janolada/Piezoelectric-Charging-Station/piezo_station/firmware/data/assets/icpep.jpg

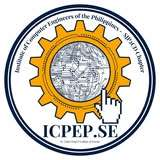
piezo_station/firmware/data/assets/icpep.jpg
