janolada/Piezoelectric-Charging-Station/piezo_station/firmware/data/assets/ike.jpg

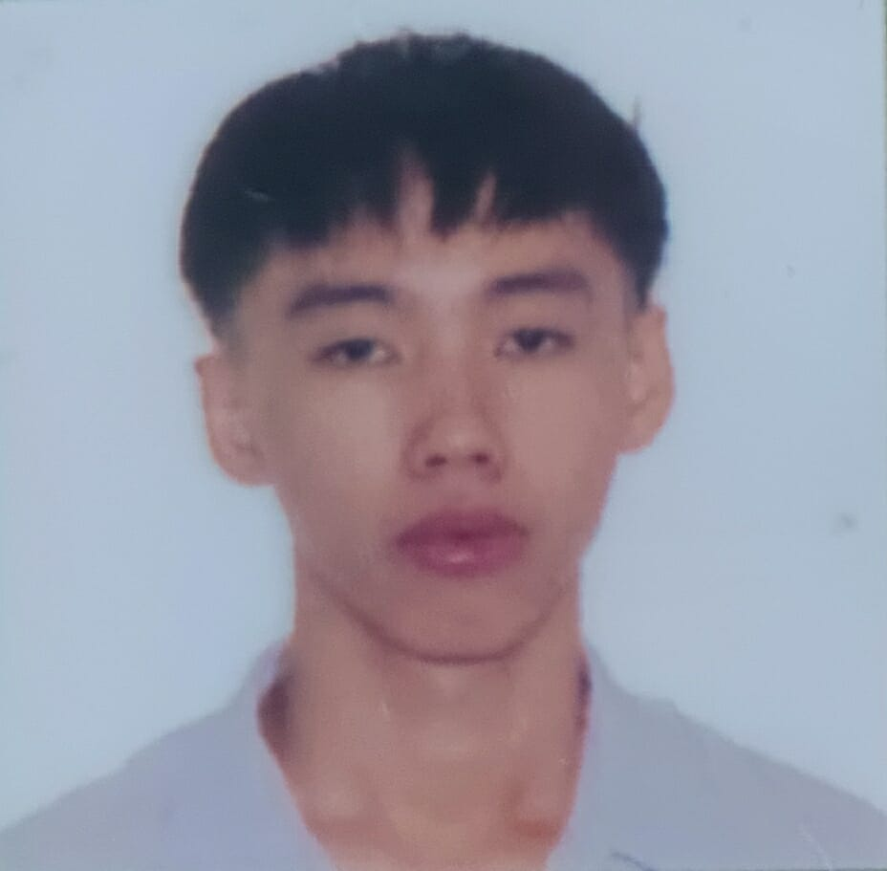
piezo_station/firmware/data/assets/ike.jpg
