janolada/Piezoelectric-Charging-Station/piezo_station/README.md

# PiezoStation: Smart Piezoelectric Energy Harvesting Charging Station

**PiezoStation** is an IoT-enabled charging station that harvests energy from piezoelectric transducers and provides secure, code-protected charging slots for mobile devices. This capstone project combines renewable energy harvesting, embedded systems control, and a web-based user interface for a complete smart charging solution.

## Project Objectives

* **Renewable Energy Harvesting:** Captures electrical energy generated by applying mechanical stress to PZT ceramic discs, storing it via a custom power management circuit.
* **Secure Access Control:** Manages three independent charging slots using a non-blocking servo state machine and randomized 4-digit unlock codes.
* **Real-Time Monitoring:** Calculates and displays bus voltage, current, and total harvested energy using an INA219 sensor in a low-side configuration.
* **Offline IoT Dashboard:** Hosts a responsive web application directly on the ESP32 using SPIFFS (SPI Flash File System), requiring no external internet connection.

## System Architecture & Technology Stack

* **Microcontroller:** ESP32-WROOM-32 (Dual-core, 240MHz) operating in WiFi Access Point Mode.
* **Firmware:** C++ / Arduino Framework featuring custom REST API handlers and non-blocking task management to prevent system delays during servo actuation.
* **Frontend Interface:** HTML5, CSS3, ES6 JavaScript, and Chart.js 4.4.1 for asynchronous data visualization.
* **Hardware Components:** INA219 Current/Voltage Sensor (I2C), SG90 Micro Servos (PWM), TP4056 Li-ion Charger, and a 3.7V 18650 Battery.

## Getting Started

### Prerequisites
* Arduino IDE with the ESP32 Board Manager installed.
* ESP32 Sketch Data Upload Plugin (required for SPIFFS).

### Installation & Setup
1. Clone this repository to your local environment.
2. Open `PiezoStation.ino` in the Arduino IDE.
3. Ensure the following library dependencies are installed: `ESP32Servo`, `Adafruit_INA219`, and `WiFi`.
4. Use the "ESP32 Sketch Data Upload" tool to upload the contents of the `/data` folder to the ESP32 SPIFFS.
5. Compile and upload the firmware to the ESP32 development board.
6. Power the system. The ESP32 will generate a WiFi Access Point with the SSID `PiezoStation`.
7. Connect to the network and navigate to `192.168.4.1` in a standard web browser to access the control dashboard.

## Repository Structure

* `/firmware`: Contains the core ESP32 C++ code (`PiezoStation.ino`) and library dependencies.
* `/firmware/data`: Contains the SPIFFS web server files (`index.html`, `style.css`, `dashboard.js`, `chart.min.js`).
* `/hardware`: Contains circuit designs, schematics, and the Bill of Materials.
* `/docs`: Contains comprehensive technical documentation and API endpoint references.

## Authors

Developed by students of St. John Paul II College of Davao (Bachelor of Science in Computer Engineering, Academic Year 2025-2026):

* **Johncel Anthony Lada** - Software & Systems Developer
* **Riche Kye Pobadora** - Hardware & Circuit Designer
* **Ike Hingo** - Researcher & Documentation 
---
*� 2026 PiezoStation Development Team. All rights reserved.*
