janolada/Piezoelectric-Charging-Station/piezo_station/docs/Technical Documentation.md

# PiezoStation: Smart Piezoelectric Energy Harvesting Charging Station

## Complete Technical Summary

---

## EXECUTIVE SUMMARY

**Project Title**: PiezoStation - Piezoelectric Energy Harvesting Charging Station  
**Institution**: St. John Paul II College of Davao, College of Engineering  
**Program**: Bachelor of Science in Computer Engineering  
**Academic Year**: 2025-2026  
**Project Type**: Capstone/Thesis Project

**Team Members**:

- **Ike Hingo** - Researcher & Documentation Specialist
- **Johncel Anthony Lada** - Software Engineer & Systems Developer
- **Riche Kye Pobadora** - Hardware Engineer & Circuit Designer

**Project Description**: PiezoStation is an innovative IoT-enabled charging station that harvests energy from piezoelectric transducers and provides secure, code-protected charging slots for mobile devices. The system combines renewable energy harvesting, embedded systems control, and web-based user interface for a complete smart charging solution.

---

## TABLE OF CONTENTS

Project Objectives

System Architecture

Hardware Components

Software Implementation

Energy Harvesting Technology

System Operation & Workflows

Technical Specifications

Circuit Design & Schematics

Code Documentation

Testing & Validation

Challenges & Solutions

Results & Performance

Future Enhancements

Conclusion
---

## 1. PROJECT OBJECTIVES

### Primary Objectives

1. **Harvest renewable energy** from piezoelectric elements
2. **Store harvested energy** efficiently in rechargeable battery
3. **Provide secure device charging** with access control
4. **Monitor battery energy state** in real-time via INA219 sensor
5. **Enable remote control** via web interface

### Secondary Objectives

1. Demonstrate practical IoT implementation
2. Integrate embedded systems with web technologies
3. Create user-friendly interface for non-technical users
4. Implement security measures for device protection
5. Provide data analytics for energy monitoring

### Learning Outcomes

- **Embedded Systems**: ESP32 programming, sensor integration
- **Web Development**: Full-stack dashboard creation
- **Hardware Design**: Circuit assembly, mechanical integration
- **Energy Systems**: Understanding piezoelectric technology
- **Project Management**: Team collaboration, documentation

---

## 2. SYSTEM ARCHITECTURE

### 2.1 High-Level Architecture

```
┌─────────────────────────────────────────────────────────────┐
│                    USER INTERFACE LAYER                      │
│  ┌──────────────┐  ┌──────────────┐  ┌──────────────┐      │
│  │   Web App    │  │  Mobile View │  │ Admin Panel  │      │
│  │ (Dashboard)  │  │ (Responsive) │  │  (Control)   │      │
│  └──────┬───────┘  └──────┬───────┘  └──────┬───────┘      │
└─────────┼──────────────────┼──────────────────┼─────────────┘
          │                  │                  │
          └──────────────────┴──────────────────┘
                             │ HTTP/JSON
                             │ WiFi (192.168.4.1)
          ┌──────────────────┴──────────────────┐
          │                                     │
┌─────────┴─────────────────────────────────────┴─────────────┐
│               APPLICATION LAYER (ESP32)                      │
│  ┌──────────────┐  ┌──────────────┐  ┌──────────────┐      │
│  │  Web Server  │  │  REST API    │  │ State Machine│      │
│  │   (Port 80)  │  │  (Handlers)  │  │   (Servos)   │      │
│  └──────┬───────┘  └──────┬───────┘  └──────┬───────┘      │
│         │                  │                  │              │
│  ┌──────┴──────────────────┴──────────────────┴───────┐     │
│  │          Business Logic & Control                   │     │
│  │  • Slot Management  • Code Generation               │     │
│  │  • Energy Calculation • Security Validation         │     │
│  └──────────────────────────┬──────────────────────────┘     │
└─────────────────────────────┼────────────────────────────────┘
                              │
          ┌───────────────────┴───────────────────┐
          │                                       │
┌─────────┴──────────────┐           ┌───────────┴────────────┐
│   HARDWARE LAYER       │           │   SENSOR LAYER         │
│  ┌──────────────────┐  │           │  ┌──────────────────┐  │
│  │  Servo 1 (GPIO14)│  │           │  │  INA219 (I2C)    │  │
│  │  Servo 2 (GPIO27)│  │           │  │  • Bus Voltage   │  │
│  │  Servo 3 (GPIO26)│  │           │  │  • Shunt Voltage │  │
│  │  (0° - 90°)      │  │           │  │  • Current (mA)  │  │
│  └──────────────────┘  │           │  │  • Power (mW)    │  │
└────────────────────────┘           │  └──────────────────┘  │
                                     └────────────────────────┘
          │                                       │
          └───────────────────┬───────────────────┘
                              │
┌─────────────────────────────┴────────────────────────────────┐
│                    POWER LAYER                                │
│  ┌─────────────────────────────────────────────────────┐     │
│  │  Piezoelectric Elements → Bridge Rectifier →        │     │
│  │  → Voltage Regulator → 18650 Battery (3.0-4.2V)     │     │
│  └─────────────────────────────────────────────────────┘     │
└───────────────────────────────────────────────────────────────┘
```

### 2.2 Data Flow Diagram

```
User Action (Web) → WiFi → ESP32 → Validate → Execute → Update State
                                        ↓
                                   Servo/Sensor
                                        ↓
                                   Read Status
                                        ↓
                                   JSON Response
                                        ↓
                                   Update Dashboard
```

---

## 3. HARDWARE COMPONENTS

### 3.1 Main Components

#### ESP32 Development Board

- **Model**: ESP32-WROOM-32
- **Processor**: Dual-core Xtensa LX6 @ 240MHz
- **Memory**: 520KB SRAM, 4MB Flash
- **WiFi**: 802.11 b/g/n (2.4GHz)
- **GPIO**: 34 programmable pins
- **ADC**: 12-bit, 18 channels
- **I2C**: 2 interfaces
- **PWM**: 16 channels
- **Operating Voltage**: 3.3V
- **Input Voltage**: 5V (USB) or 7-12V (VIN)

**Functions in Project**:

- WiFi Access Point creation
- Web server hosting
- API request handling
- Servo motor control (PWM)
- I2C sensor communication
- Data processing and storage

#### Servo Motors (3× SG90)

- **Type**: Micro servo (180° rotation)
- **Operating Voltage**: 4.8V - 6V
- **Current**: ~100mA (idle), ~500mA (stall)
- **Torque**: 1.8 kg/cm @ 4.8V
- **Speed**: 0.12 sec/60° @ 4.8V
- **Control**: PWM (50Hz, 1-2ms pulse width)
- **Weight**: 9g
- **Dimensions**: 22.2×11.8×31mm

**Control Angles**:

- 0° (1ms pulse) = Door LOCKED
- 90° (1.5ms pulse) = Door UNLOCKED
- Detached after movement to save power

#### INA219 Current/Voltage Sensor

- **Interface**: I2C (address 0x40)
- **Voltage Range**: 0-26V (bus voltage)
- **Current Range**: ±3.2A (with 0.1Ω shunt)
- **Resolution**: 12-bit ADC
- **Accuracy**: ±0.5% (voltage), ±1% (current)
- **Update Rate**: ~1Hz in firmware
- **Operating Voltage**: 3-5.5V

**Measurements**:

- Bus voltage (V)
- Shunt voltage (mV)
- Current (mA)
- Power (mW)
- Calculated battery voltage

#### 18650 Li-ion Battery

- **Nominal Voltage**: 3.7V
- **Voltage Range**: 3.0V (cutoff) - 4.2V (max)
- **Typical Capacity**: 2000-3500mAh
- **Chemistry**: Lithium-ion (LiCoO2)
- **Charge Rate**: 0.5C - 1C
- **Discharge Rate**: 1C - 2C continuous
- **Cycle Life**: 300-500 cycles

**Protection Required**:

- Overcharge protection (>4.2V)
- Over-discharge protection (<3.0V)
- Short circuit protection
- Temperature monitoring

### 3.2 Piezoelectric Elements

#### Specifications

- **Type**: PZT ceramic discs or patches
- **Size**: 27mm or 35mm diameter
- **Voltage Output**: 10-30V AC (peak)
- **Current Output**: 0.1-1mA (depends on force)
- **Resonant Frequency**: ~4-6kHz
- **Force Required**: 10-50N (1-5kg)

#### Energy Generation

- **Principle**: Piezoelectric effect (mechanical → electrical)
- **Application**: Foot traffic, manual pressing, vibrations
- **Output Type**: AC voltage pulses
- **Typical Power**: 1-10mW per element (intermittent)

### 3.3 Supporting Components

#### Power Management

- **Bridge Rectifier**: AC to DC conversion (1N4007 diodes)
- **Voltage Regulator**: 5V output for ESP32 (LM7805 or buck converter)
- **Capacitors**: Smoothing (100µF, 1000µF electrolytic)
- **Battery Charger**: TP4056 Li-ion charging module

#### Mechanical Components

- **Enclosure**: 3D printed or acrylic case
- **Door Mechanism**: Servo-actuated latches
- **Mounting**: Servo brackets, battery holder
- **Piezo Platform**: Pressure distribution platform

---

## 4. SOFTWARE IMPLEMENTATION

### 4.1 Firmware Architecture (ESP32)

#### File Structure

```
PiezoStation/
├── PiezoStation.ino          # Main firmware
├── data/                      # SPIFFS web files
│   ├── index.html            # Dashboard UI
│   ├── style.css             # Styling
│   ├── dashboard.js          # Frontend logic
│   ├── chart.min.js          # Chart.js library
│   └── images/               # Team photos, logos
├── libraries/                 # Dependencies
│   ├── ESP32Servo/
│   ├── Adafruit_INA219/
│   └── WiFi/
└── README.md                  # Documentation
```

#### Main Components

**1. Configuration Section**

```cpp
// WiFi credentials
const char* ssid = "PiezoStation";
const char* password = "12345678";

// Admin security
const char* ADMIN_SECURITY_KEY = "PZSTAT001";

// Servo pins and angles
const int servoPins[3] = {14, 27, 26};
const int SERVO_LOCKED_ANGLE = 0;
const int SERVO_UNLOCKED_ANGLE = 90;
```

**2. Data Structures**

```cpp
// Slot state management
struct Slot {
  bool occupied;      // true if device stored
  String code;        // 4-digit unlock code
};
Slot slotData[3];     // Array for 3 slots

// Servo state machine
enum ServoState { IDLE, MOVING, COOLDOWN };
struct ServoTask {
  ServoState state;
  unsigned long startTime;
  int slotIndex;
  int targetAngle;
};
```

**3. Non-Blocking Servo Control**

```cpp
void updateServos() {
  // State: IDLE → MOVING → COOLDOWN → IDLE
  switch (currentTask.state) {
    case MOVING:
      if (elapsed >= SERVO_MOVE_DELAY) {
        currentTask.state = COOLDOWN;
      }
      break;
    case COOLDOWN:
      if (elapsed >= SERVO_DETACH_DELAY) {
        servo->detach();  // Save power
        currentTask.state = IDLE;
      }
      break;
  }
}
```

**4. Energy Calculation Algorithm**

```cpp
void readSensors() {
  // Read INA219
  float voltage = getBatteryVoltage();
  float current = getCurrent();
  
  // Calculate energy
  float elapsedSeconds = (now - lastRead) / 1000.0;
  float chargeCoulombs = current * elapsedSeconds;
  float energyJoules = chargeCoulombs * voltage;
  
  // Accumulate
  totalHarvestedEnergy += energyJoules;
}
```

**5. API Endpoints**

```cpp
server.on("/getData", HTTP_GET, handleGetData);
server.on("/requestLock", HTTP_GET, handleRequestLock);
server.on("/confirmLock", HTTP_GET, handleConfirmLock);
server.on("/unlockSlot", HTTP_GET, handleUnlockSlot);
server.on("/adminUnlock", HTTP_GET, handleAdminUnlock);
server.on("/adminReset", HTTP_GET, handleAdminReset);
```

### 4.2 Web Dashboard (Frontend)

#### Technology Stack

- **HTML5**: Semantic structure
- **CSS3**: Modern styling, flexbox, grid
- **JavaScript (ES6+)**: Async/await, fetch API
- **Chart.js 4.4.1**: Real-time data visualization
- **Responsive Design**: Mobile-first approach

#### Key Features

**1. Real-Time Updates**

```javascript
// Poll server every 2 seconds
setInterval(fetchData, 2000);

async function fetchData() {
  const response = await fetch('/getData');
  const data = await response.json();
  updateUI(data);
}
```

**2. Slot Management**

```javascript
async function handleSlotClick(slotId) {
  if (slotOccupied) {
    // Show unlock modal
    showUnlockModal(slotId);
  } else {
    // Request lock, get code
    const response = await fetch(`/requestLock?slot=${slotId}`);
    const {code} = await response.json();
    displayCode(code);
  }
}
```

**3. Energy Visualization**

```javascript
// Chart.js configuration
const chart = new Chart(ctx, {
  type: 'line',
  data: {
    datasets: [
      {label: 'Voltage (V)', data: voltageData},
      {label: 'Energy (J)', data: energyData}
    ]
  }
});
```

**4. Admin Panel**

```javascript
// Secured with password
if (username === 'admin' && password === 'piezo2024') {
  showAdminPanel();
}

// Force unlock any slot
async function adminUnlock(slot) {
  await fetch(`/adminUnlock?slot=${slot}&key=PZSTAT001`);
}
```

#### User Interface Components

**Dashboard Tab**:

- Live voltage/current/energy display
- Battery percentage indicator
- 3 interactive slot cards
- System status (operational/offline)

**Analytics Tab**:

- Real-time line chart (voltage & energy)
- Peak voltage tracker
- Total harvested energy
- Harvest status indicator

**Team Tab**:

- Team member profiles
- Educational background
- Project roles
- Institutional affiliations

**Modals**:

- Code display modal (after reservation)
- Unlock input modal (code entry)
- Admin login modal
- Admin control panel

---

## 5. ENERGY HARVESTING TECHNOLOGY

### 5.1 Piezoelectric Effect

#### Scientific Principle

**Piezoelectricity**: Generation of electric charge in response to mechanical stress

**Formula**:

```
V = g × t × F / A

Where:
V = Voltage output
g = Piezoelectric voltage constant (0.055 Vm/N for PZT)
t = Thickness of element
F = Applied force
A = Area
```

#### Mechanism

1. **Mechanical Stress**: Pressure applied to piezo element
2. **Crystal Deformation**: PZT ceramic structure distorts
3. **Charge Separation**: Positive and negative charges separate
4. **Voltage Generation**: Potential difference across electrodes
5. **Current Flow**: When connected to circuit

### 5.2 Energy Conversion Chain

```
Mechanical Energy (Footsteps/Pressure)
          ↓
Piezoelectric Transduction
          ↓
AC Electrical Energy (10-30V, <1mA)
          ↓
Bridge Rectification (4× 1N4007)
          ↓
DC Electrical Energy (Pulsed)
          ↓
Smoothing Capacitors (1000µF)       ← ⚠ See Deployment Note below
          ↓
TP4056 Charger Module
          ↓
18650 Battery Storage (3.7V, 2000-3500mAh)
          ↓
Buck Converter (3.7V → 5V)
          ↓
ESP32 & System (5V/3.3V)
```

> **⚠ Deployment Note**: The energy conversion chain above represents the theoretically correct and intended circuit design. During prototype deployment on the stair installation, normal foot traffic generated piezoelectric output voltage that fell below the minimum operating threshold of the 1000µF smoothing capacitor. As a result, the capacitor did not accumulate sufficient charge to reliably trigger the TP4056 charging cycle. In the deployed system, the 18650 battery acts as the primary energy buffer, and the INA219 sensor monitors battery charge state as a proxy for system energy. The piezoelectric circuit remains functional and demonstrates the correct harvesting principle; the limitation is one of scale — the prototype stair installation did not generate the force levels required for sustained capacitor charging. See **Section 11, Challenge 9** for the full analysis and proposed hardware fix.

### 5.3 Power Budget

#### Energy Generation (Theoretical Estimate — Lab Conditions)

> **Note**: The following figures are based on controlled lab testing and theoretical calculations. During stair deployment, sustained capacitor charging was not achieved due to voltage threshold limitations. See Section 11, Challenge 9.

- **Single Piezo Step**: ~10mJ (0.01J)
- **100 Steps/Hour**: 1J/hour
- **4 Piezo Elements**: 4J/hour
- **8 Hours/Day**: ~32J/day
- **Daily Wh**: 32J ÷ 3600 = 0.009Wh

#### Power Consumption

|Component|Current|Power|Duty Cycle|Avg Power|
|---|---|---|---|---|
|ESP32 (Active)|160mA|0.8W|100%|0.8W|
|ESP32 (WiFi TX)|240mA|1.2W|10%|0.12W|
|Servos (Moving)|500mA|2.5W|1%|0.025W|
|INA219|1mA|0.005W|100%|0.005W|
|**TOTAL**||||**~0.95W**|

#### Battery Runtime

```
Battery: 3000mAh × 3.7V = 11.1Wh
Runtime: 11.1Wh ÷ 0.95W = 11.7 hours
```

**Note**: System designed for supplemental charging, not standalone operation

### 5.4 Energy Monitoring

#### INA219 Measurements

> **Measurement Context**: The INA219 is positioned on the load side of the 18650 battery, measuring battery voltage and discharge current. In the deployed system, this reflects battery charge state rather than instantaneous piezoelectric output. Energy readings on the dashboard represent accumulated battery energy as a proxy for harvested energy.

```cpp
// Read sensor
float busV = ina219.getBusVoltage_V();
float shuntV = ina219.getShuntVoltage_mV();
float current = ina219.getCurrent_mA();
float power = ina219.getPower_mW();

// Calculate battery voltage
if (lowSideConfig) {
  batteryV = power / current;  // V = P/I
} else {
  batteryV = busV + (shuntV / 1000);
}
```

#### Energy Accumulation

```cpp
// E = ∫(V × I) dt
// Approximation: E ≈ V × I × Δt

float Δt = (currentTime - lastTime) / 1000.0;  // seconds
float charge = current × Δt;  // Coulombs
float energy = charge × voltage;  // Joules

totalEnergy += energy;
```

#### Conversion Factors

- **1 Joule (J)** = 1 Watt-second
- **1 Watt-hour (Wh)** = 3600 Joules
- **1 mAh @ 3.7V** = 0.00370 Wh = 13.32 J

---

## 6. SYSTEM OPERATION & WORKFLOWS

### 6.1 User Lock Workflow (Detailed)

```
┌──────────────────────────────────────────────────────────┐
│ 1. USER: Opens dashboard (192.168.4.1)                   │
└────────────────────┬─────────────────────────────────────┘
                     ↓
┌──────────────────────────────────────────────────────────┐
│ 2. SYSTEM: Serves index.html from SPIFFS                 │
│    • Loads dashboard.js, style.css, chart.min.js         │
│    • Establishes WebSocket or polling connection         │
└────────────────────┬─────────────────────────────────────┘
                     ↓
┌──────────────────────────────────────────────────────────┐
│ 3. DASHBOARD: Fetches /getData every 2 seconds           │
│    Response: {voltage, current, energy, slots}           │
│    • Updates battery indicator (0-100%)                  │
│    • Updates voltage display (3.0-4.2V)                  │
│    • Shows slot status (vacant/occupied)                 │
└────────────────────┬─────────────────────────────────────┘
                     ↓
┌──────────────────────────────────────────────────────────┐
│ 4. USER: Clicks vacant slot card (e.g., Slot 2)          │
└────────────────────┬─────────────────────────────────────┘
                     ↓
┌──────────────────────────────────────────────────────────┐
│ 5. JAVASCRIPT: handleSlotClick(2) triggered              │
│    • Checks if system busy (isSystemBusy flag)           │
│    • Sends GET /requestLock?slot=2                       │
└────────────────────┬─────────────────────────────────────┘
                     ↓
┌──────────────────────────────────────────────────────────┐
│ 6. ESP32: handleRequestLock() executed                   │
│    a) Validates slot number (1-3)                        │
│    b) Checks slot availability (!occupied)               │
│    c) Checks servo state (IDLE)                          │
│    d) Generates code: random(1000, 10000) → "5847"       │
│    e) Sets: slotData[1].code = "5847"                    │
│    f) Sets: slotData[1].occupied = true                  │
│    g) Calls: moveServo(2, 90)                            │
└────────────────────┬─────────────────────────────────────┘
                     ↓
┌──────────────────────────────────────────────────────────┐
│ 7. SERVO OPERATION: Non-blocking state machine           │
│    • servo2.attach(27)                                   │
│    • servo2.write(90)  // 0° → 90°                       │
│    • currentTask.state = MOVING                          │
│    • Wait 600ms (SERVO_MOVE_DELAY)                       │
│    • currentTask.state = COOLDOWN                        │
│    • Wait 100ms (SERVO_DETACH_DELAY)                     │
│    • servo2.detach()  // Power saving                    │
│    • currentTask.state = IDLE                            │
└────────────────────┬─────────────────────────────────────┘
                     ↓
┌──────────────────────────────────────────────────────────┐
│ 8. ESP32: Returns JSON response                          │
│    {"success": true, "code": "5847"}                     │
└────────────────────┬─────────────────────────────────────┘
                     ↓
┌──────────────────────────────────────────────────────────┐
│ 9. DASHBOARD: Displays code modal                        │
│    • Shows large code: "5847"                            │
│    • Instruction: "Remember this code!"                  │
│    • Button: "Lock Door" (confirmLock)                   │
└────────────────────┬─────────────────────────────────────┘
                     ↓
┌──────────────────────────────────────────────────────────┐
│ 10. USER: Places device in slot, clicks "Lock Door"      │
└────────────────────┬─────────────────────────────────────┘
                     ↓
┌──────────────────────────────────────────────────────────┐
│ 11. JAVASCRIPT: Sends GET /confirmLock?slot=2            │
└────────────────────┬─────────────────────────────────────┘
                     ↓
┌──────────────────────────────────────────────────────────┐
│ 12. ESP32: handleConfirmLock() executed                  │
│     • Validates slot is occupied                         │
│     • Calls: moveServo(2, 0)  // 90° → 0° (CLOSE)        │
│     • Returns: {"success": true}                         │
└────────────────────┬─────────────────────────────────────┘
                     ↓
┌──────────────────────────────────────────────────────────┐
│ 13. DASHBOARD: Closes modal, updates slot UI             │
│     • Slot 2 now shows "Charging" (occupied)             │
│     • Green indicator → Red indicator                    │
│     • Toast message: "Slot secured!"                     │
└──────────────────────────────────────────────────────────┘
```

### 6.2 User Unlock Workflow (Detailed)

```
┌──────────────────────────────────────────────────────────┐
│ 1. USER: Clicks occupied slot (e.g., Slot 2)             │
└────────────────────┬─────────────────────────────────────┘
                     ↓
┌──────────────────────────────────────────────────────────┐
│ 2. DASHBOARD: Opens unlock modal                         │
│    • Input field for 4-digit code                        │
│    • "Unlock Slot" button                                │
└────────────────────┬─────────────────────────────────────┘
                     ↓
┌──────────────────────────────────────────────────────────┐
│ 3. USER: Enters code "5847", clicks Unlock               │
└────────────────────┬─────────────────────────────────────┘
                     ↓
┌──────────────────────────────────────────────────────────┐
│ 4. JAVASCRIPT: Validates input (4 digits)                │
│    • Sends: GET /unlockSlot?slot=2&code=5847             │
└────────────────────┬─────────────────────────────────────┘
                     ↓
┌──────────────────────────────────────────────────────────┐
│ 5. ESP32: handleUnlockSlot() executed                    │
│    a) Validates slot number                              │
│    b) Checks if slot occupied                            │
│    c) Compares: inputCode == slotData[1].code            │
│    d) If MATCH:                                          │
│       • slotData[1].occupied = false                     │
│       • slotData[1].code = ""                            │
│       • moveServo(2, 90)  // Open door                   │
│       • Return: {"success": true}                        │
│    e) If MISMATCH:                                       │
│       • Return: {"success": false, "error": "Invalid"}   │
└────────────────────┬─────────────────────────────────────┘
                     ↓
┌──────────────────────────────────────────────────────────┐
│ 6. DASHBOARD: Handles response                           │
│    • If success: "Slot unlocked! Retrieve device"        │
│    • If failed: "Invalid code, try again"                │
│    • Updates slot UI to "Available"                      │
└────────────────────┬─────────────────────────────────────┘
                     ↓
┌──────────────────────────────────────────────────────────┐
│ 7. USER: Retrieves device from open slot                 │
└──────────────────────────────────────────────────────────┘
```

### 6.3 Continuous Energy Monitoring

```
┌──────────────────────────────────────────────────────────┐
│ MAIN LOOP (runs continuously)                            │
│                                                           │
│ void loop() {                                            │
│   server.handleClient();  // Process HTTP requests       │
│   updateServos();         // Update servo state machine  │
│                                                           │
│   if (millis() - lastRead >= 1000) {  // Every 1 second │
│     readSensors();                                       │
│   }                                                      │
│ }                                                        │
└────────────────────┬─────────────────────────────────────┘
                     ↓
┌──────────────────────────────────────────────────────────┐
│ readSensors() - Called every second                      │
│                                                           │
│ 1. Read INA219:                                          │
│    • busVoltage = 0.05V (low-side config)                │
│    • current = 87.3mA                                    │
│    • power = 323mW                                       │
│                                                           │
│ 2. Calculate Battery Voltage:                            │
│    • voltage = power / current                           │
│    • voltage = 0.323W / 0.0873A = 3.70V                  │
│                                                           │
│ 3. Calculate Energy:                                     │
│    • Δt = 1.0 second                                     │
│    • charge = 0.0873A × 1.0s = 0.0873 Coulombs          │
│    • energy = 0.0873C × 3.70V = 0.323 Joules            │
│    • totalEnergy += 0.323J                               │
│                                                           │
│ 4. Update Variables:                                     │
│    • voltage = 3.70V                                     │
│    • current = 0.087A                                    │
│    • totalHarvestedEnergy = 1247.8J                      │
│    • batteryPercent = 58%  (3.7V = ~58%)                │
└────────────────────┬─────────────────────────────────────┘
                     ↓
┌──────────────────────────────────────────────────────────┐
│ DASHBOARD: Polls /getData every 2 seconds                │
│                                                           │
│ GET /getData Response:                                   │
│ {                                                        │
│   "voltage": 3.70,                                       │
│   "current": 0.087,                                      │
│   "harvestedEnergy": 1247.8,                             │
│   "battery": 58,                                         │
│   "sensorActive": true,                                  │
│   "slots": {                                             │
│     "1": {"occupied": false},                            │
│     "2": {"occupied": true},                             │
│     "3": {"occupied": false}                             │
│   }                                                      │
│ }                                                        │
└────────────────────┬─────────────────────────────────────┘
                     ↓
┌──────────────────────────────────────────────────────────┐
│ DASHBOARD: Updates UI elements                           │
│ • Battery: 58% (updates progress bar color)              │
│ • Voltage: 3.70 V                                        │
│ • Current: 0.087 A                                       │
│ • Total Energy: 1247.8 J (0.35 Wh)                       │
│ • Chart: Adds new data point                             │
│ • Slot 2: Shows "Charging" status                        │
└──────────────────────────────────────────────────────────┘
```

---

## 7. TECHNICAL SPECIFICATIONS

### 7.1 System Specifications

|Parameter|Specification|
|---|---|
|**Operating Voltage**|5V DC (USB) or 7-12V DC (VIN)|
|**Battery Voltage**|3.0V - 4.2V (18650 Li-ion)|
|**WiFi Standard**|IEEE 802.11 b/g/n (2.4GHz)|
|**WiFi Mode**|Access Point (AP)|
|**IP Address**|192.168.4.1 (default)|
|**Web Server Port**|80 (HTTP)|
|**Communication Protocol**|HTTP/JSON REST API|
|**Number of Slots**|3 independent slots|
|**Access Control**|4-digit numeric code (1000-9999)|
|**Servo Type**|180° micro servo (SG90)|
|**Sensor Interface**|I2C (INA219)|
|**Data Update Rate**|1Hz (sensor), 0.5Hz (dashboard)|
|**File System**|SPIFFS (SPI Flash File System)|
|**Web Storage**|~2MB (HTML/CSS/JS/Images)|

### 7.2 Performance Specifications

|Metric|Value|
|---|---|
|**Servo Response Time**|600ms (0° to 90°)|
|**Code Generation Time**|<10ms|
|**API Response Time**|<100ms (typical)|
|**Dashboard Load Time**|<2s (first load)|
|**Page Update Frequency**|Every 2 seconds|
|**Concurrent Users**|Up to 4 (WiFi limit)|
|**Energy Measurement Accuracy**|±2% (INA219 dependent)|
|**Voltage Measurement Range**|0-26V (0.4% accuracy)|
|**Current Measurement Range**|±3.2A (±10mA resolution)|
|**Power Consumption (Idle)**|~200mA @ 5V (1W)|
|**Power Consumption (Active)**|~500mA @ 5V (2.5W)|

### 7.3 Environmental Specifications

|Parameter|Range|
|---|---|
|**Operating Temperature**|0°C to 50°C|
|**Storage Temperature**|-20°C to 70°C|
|**Humidity**|20% to 80% RH (non-condensing)|
|**Piezo Force Required**|10-50N (1-5kg weight)|
|**Piezo Voltage Output**|10-30V AC (peak)|
|**Piezo Current Output**|0.1-1mA (per step)|

---

## 8. CIRCUIT DESIGN & SCHEMATICS

### 8.1 Power Circuit

```
Piezoelectric Elements (4x in parallel)
    │
    ├──[Piezo 1]──┐
    ├──[Piezo 2]──┤
    ├──[Piezo 3]──┤ (AC Output: 10-30V, <1mA each)
    └──[Piezo 4]──┘
         │
         ↓
    Bridge Rectifier (1N4007 × 4)
         ┌──[D1]──┐
    AC──┤         ├──DC+
         └──[D2]──┘
         ┌──[D3]──┐
    AC──┤         ├──DC-
         └──[D4]──┘
         │
         ↓
    Smoothing Capacitor (1000µF/50V)
         │
         ↓
    TP4056 Li-ion Charger Module
    • IN+: Rectified DC
    • IN-: Ground
    • BAT+: 18650 positive
    • BAT-: 18650 negative
    • CHG LED: Charging indicator
    • STBY LED: Standby indicator
         │
         ↓
    18650 Battery (3.7V, 2000-3500mAh)
    • Protected cell (BMS built-in)
    • Voltage range: 3.0V - 4.2V
         │
         ↓
    Buck Converter (3.7V → 5V)
    • Input: 3.0-4.2V
    • Output: 5V @ 1-2A
    • Efficiency: ~85%
         │
         ├──→ ESP32 (5V VIN)
         ├──→ Servos (5V, through ESP32 regulated)
         └──→ INA219 (5V VCC)
```

### 8.2 Control Circuit

```
ESP32 Development Board
    ┌─────────────────────────────────────┐
    │  ESP32-WROOM-32                     │
    │                                     │
    │  GPIO 14 ────────→ Servo 1 Signal  │──→ [Servo Motor 1]
    │  GPIO 27 ────────→ Servo 2 Signal  │──→ [Servo Motor 2]
    │  GPIO 26 ────────→ Servo 3 Signal  │──→ [Servo Motor 3]
    │                                     │
    │  GPIO 21 (SDA) ──┐                 │
    │  GPIO 22 (SCL) ──┼─→ I2C Bus       │
    │  3.3V ──────────→ Pullup (4.7kΩ)   │
    │                  │                  │
    │  5V ─────────────┼─→ VCC (INA219)  │──→ [INA219 Module]
    │  GND ────────────┼─→ GND (INA219)  │      │
    │                  │  SDA ────────────────┘  │
    │                  │  SCL ────────────────┘  │
    │                  │                         │
    │                  └─→ I2C Address: 0x40    │
    │                                            │
    │  VIN (5V) ←───── Buck Converter            │
    │  GND ←────────── Common Ground             │
    └────────────────────────────────────────────┘

Common Ground Bus:
    • ESP32 GND
    • Battery GND
    • Servo GND (all 3)
    • INA219 GND
    • Buck converter GND
```

### 8.3 INA219 Connection (Low-Side Sensing)

```
    Battery (+) ──────────────────┬──→ Load (ESP32, Servos)
                                  │
                                  │
    INA219 Module                 │
    ┌──────────────────┐         │
    │ VIN- ←───────────┼─────────┘
    │                  │
    │ VIN+ ←───────────┼──[Shunt 0.1Ω]──→ GND
    │                  │
    │ VCC ←──── 5V     │
    │ GND ←──── GND    │
    │ SDA ←──── GPIO21 │
    │ SCL ←──── GPIO22 │
    └──────────────────┘

Calculation:
    Current = Shunt Voltage / Shunt Resistance
    Current = V_shunt / 0.1Ω

    Battery Voltage = Power / Current
    (Because VIN- ≈ 0V in low-side config)
```

### 8.4 Servo Wiring

```
Each Servo (SG90):
    ┌─────────────┐
    │   Servo 1   │
    ├─────────────┤
    │ Brown  (GND)│←── ESP32 GND
    │ Red    (VCC)│←── ESP32 5V (or external 5V)
    │ Orange (PWM)│←── ESP32 GPIO 14
    └─────────────┘

PWM Signal (50Hz):
    • 1.0ms pulse = 0°   (locked)
    • 1.5ms pulse = 90°  (unlocked)
    • 2.0ms pulse = 180° (not used)

Note: For reliable operation, power servos from
external 5V supply if all 3 move simultaneously.
ESP32's 5V pin may not provide sufficient current.
```

---

## 9. CODE DOCUMENTATION

### 9.1 Firmware Key Functions

#### setup()

```cpp
/**
 * @brief System initialization
 * @details Initializes all hardware and software components
 * 
 * Sequence:
 * 1. Serial communication (115200 baud)
 * 2. I2C bus (GPIO 21/22)
 * 3. SPIFFS filesystem
 * 4. INA219 sensor detection
 * 5. WiFi Access Point
 * 6. Servo initialization (lock all)
 * 7. Web server routes
 * 8. Start web server
 */
void setup() {
  Wire.begin(21, 22);
  Serial.begin(115200);
  
  // Mount SPIFFS for web files
  SPIFFS.begin(true);
  
  // Detect INA219
  ina219Available = ina219.begin();
  
  // Create WiFi AP
  WiFi.softAP(ssid, password);
  
  // Initialize servos to locked
  for(int i = 0; i < 3; i++) {
    Servo* s = getServo(i);
    s->attach(servoPins[i]);
    s->write(SERVO_LOCKED_ANGLE);
    delay(SERVO_MOVE_DELAY);
    s->detach();
  }
  
  // Configure routes
  server.on("/getData", HTTP_GET, handleGetData);
  // ... other routes
  
  server.begin();
}
```

#### loop()

```cpp
/**
 * @brief Main execution loop
 * @details Runs continuously, handles:
 * - HTTP requests
 * - Servo state machine
 * - Periodic sensor readings
 */
void loop() {
  server.handleClient();  // Process incoming HTTP
  updateServos();         // Non-blocking servo control
  
  // Read sensors every 1 second
  if (millis() - lastSensorRead >= 1000) {
    lastSensorRead = millis();
    readSensors();
  }
}
```

#### moveServo()

```cpp
/**
 * @brief Initiates servo movement
 * @param slot Slot number (1-3)
 * @param targetAngle Desired angle (0 or 90)
 * 
 * @details Non-blocking operation using state machine
 * - Attaches servo
 * - Commands movement
 * - Starts state machine (MOVING → COOLDOWN → IDLE)
 * - Detaches servo to save power
 */
void moveServo(int slot, int targetAngle) {
  // Validation
  if (currentTask.state != IDLE) return;
  if (slot < 1 || slot > 3) return;
  
  // Get servo object
  int index = slot - 1;
  Servo* servo = getServo(index);
  
  // Attach and command
  servo->attach(servoPins[index]);
  delay(10);
  servo->write(targetAngle);
  
  // Start state machine
  currentTask.slotIndex = index;
  currentTask.targetAngle = targetAngle;
  currentTask.startTime = millis();
  currentTask.state = MOVING;
}
```

#### readSensors()

```cpp
/**
 * @brief Reads INA219 and calculates energy
 * 
 * @details
 * - Reads voltage, current, power from INA219
 * - Handles low-side sensing configuration
 * - Calculates energy: E = V × I × Δt
 * - Accumulates total harvested energy
 * - Provides debug output
 */
void readSensors() {
  // Read INA219
  float busV = ina219.getBusVoltage_V();
  float current_mA = ina219.getCurrent_mA();
  float power_W = ina219.getPower_mW() / 1000.0;
  
  // Calculate battery voltage (low-side fix)
  float voltage = (busV < 0.1) ? 
    power_W / (current_mA / 1000.0) : busV;
  
  // Calculate energy
  float dt = (millis() - lastTime) / 1000.0;
  float charge = (current_mA / 1000.0) * dt;
  float energy = charge * voltage;
  
  totalHarvestedEnergy += energy;
  
  // Update globals
  this->voltage = voltage;
  this->current = current_mA / 1000.0;
}
```

### 9.2 API Handler Functions

#### handleGetData()

```cpp
/**
 * @api {GET} /getData Get System Status
 * @apiName GetData
 * @apiGroup System
 * 
 * @apiSuccess {Number} voltage Battery voltage (V)
 * @apiSuccess {Number} current Charging current (A)
 * @apiSuccess {Number} harvestedEnergy Total energy (J)
 * @apiSuccess {Number} battery Battery percentage (0-100)
 * @apiSuccess {Boolean} sensorActive INA219 availability
 * @apiSuccess {Object} slots Slot occupancy status
 * 
 * @apiSuccessExample {json} Success-Response:
 * {
 *   "voltage": 3.75,
 *   "current": 0.092,
 *   "harvestedEnergy": 1580.3,
 *   "battery": 62,
 *   "sensorActive": true,
 *   "slots": {
 *     "1": {"occupied": false},
 *     "2": {"occupied": true},
 *     "3": {"occupied": false}
 *   }
 * }
 */
void handleGetData() {
  // Build JSON response
  String json = "{";
  json += "\"voltage\":" + String(voltage, 2) + ",";
  json += "\"current\":" + String(current, 3) + ",";
  json += "\"harvestedEnergy\":" + String(totalHarvestedEnergy, 2) + ",";
  
  // Calculate battery percentage
  int pct = map(voltage * 100, 300, 420, 0, 100);
  pct = constrain(pct, 0, 100);
  json += "\"battery\":" + String(pct) + ",";
  
  json += "\"sensorActive\":" + 
    String(ina219Available ? "true" : "false") + ",";
  
  // Slot status
  json += "\"slots\":{";
  for(int i = 0; i < 3; i++) {
    json += "\"" + String(i+1) + "\":{";
    json += "\"occupied\":" + 
      String(slotData[i].occupied ? "true" : "false");
    json += "}";
    if (i < 2) json += ",";
  }
  json += "}}";
  
  server.send(200, "application/json", json);
}
```

#### handleRequestLock()

```cpp
/**
 * @api {GET} /requestLock Reserve Slot
 * @apiName RequestLock
 * @apiGroup Slots
 * 
 * @apiParam {Number} slot Slot number (1-3)
 * 
 * @apiSuccess {Boolean} success Operation result
 * @apiSuccess {String} code 4-digit unlock code
 * 
 * @apiError {String} error Error message
 * @apiError (400) MissingParameter slot parameter required
 * @apiError (409) SlotOccupied Slot already in use
 * @apiError (503) SystemBusy Servo operation in progress
 * 
 * @apiSuccessExample {json} Success:
 * {"success": true, "code": "5847"}
 * 
 * @apiErrorExample {json} Error:
 * {"success": false, "error": "Slot occupied"}
 */
void handleRequestLock() {
  // Validate parameters
  if (!server.hasArg("slot")) {
    server.send(400, "application/json", 
      "{\"success\":false,\"error\":\"Missing slot\"}");
    return;
  }
  
  int slot = server.arg("slot").toInt();
  
  // Validate slot number
  if (slot < 1 || slot > 3) {
    server.send(400, "application/json", 
      "{\"success\":false,\"error\":\"Invalid slot\"}");
    return;
  }
  
  int i = slot - 1;
  
  // Check availability
  if (slotData[i].occupied) {
    server.send(409, "application/json", 
      "{\"success\":false,\"error\":\"Slot occupied\"}");
    return;
  }
  
  // Check servo state
  if (currentTask.state != IDLE) {
    server.send(503, "application/json", 
      "{\"success\":false,\"error\":\"System busy\"}");
    return;
  }
  
  // Generate code
  String code = String(random(1000, 10000));
  slotData[i].code = code;
  slotData[i].occupied = true;
  
  // Open door
  moveServo(slot, SERVO_UNLOCKED_ANGLE);
  
  // Respond
  String response = "{\"success\":true,\"code\":\"" + code + "\"}";
  server.send(200, "application/json", response);
}
```

#### handleUnlockSlot()

```cpp
/**
 * @api {GET} /unlockSlot Unlock Slot
 * @apiName UnlockSlot
 * @apiGroup Slots
 * 
 * @apiParam {Number} slot Slot number (1-3)
 * @apiParam {String} code 4-digit unlock code
 * 
 * @apiSuccess {Boolean} success Operation result
 * 
 * @apiError {String} error Error message
 * @apiError (400) InvalidParameters Missing slot or code
 * @apiError (401) InvalidCode Wrong unlock code
 * @apiError (503) SystemBusy Servo operation in progress
 * 
 * @apiDescription
 * Validates unlock code and opens slot door if correct.
 * Clears slot data (occupied=false, code="") upon success.
 */
void handleUnlockSlot() {
  // Validate parameters
  if (!server.hasArg("slot") || !server.hasArg("code")) {
    server.send(400, "application/json", 
      "{\"success\":false,\"error\":\"Missing parameters\"}");
    return;
  }
  
  int slot = server.arg("slot").toInt();
  String inputCode = server.arg("code");
  inputCode.trim();
  
  // Validate slot
  if (slot < 1 || slot > 3) {
    server.send(400, "application/json", 
      "{\"success\":false,\"error\":\"Invalid slot\"}");
    return;
  }
  
  int i = slot - 1;
  
  // Check if occupied
  if (!slotData[i].occupied) {
    server.send(400, "application/json", 
      "{\"success\":false,\"error\":\"Slot not in use\"}");
    return;
  }
  
  // Verify code
  if (slotData[i].code != inputCode) {
    server.send(401, "application/json", 
      "{\"success\":false,\"error\":\"Invalid code\"}");
    return;
  }
  
  // Check servo
  if (currentTask.state != IDLE) {
    server.send(503, "application/json", 
      "{\"success\":false,\"error\":\"System busy\"}");
    return;
  }
  
  // Clear slot
  slotData[i].occupied = false;
  slotData[i].code = "";
  
  // Open door
  moveServo(slot, SERVO_UNLOCKED_ANGLE);
  
  server.send(200, "application/json", "{\"success\":true}");
}
```

### 9.3 JavaScript Key Functions

#### fetchData()

```javascript
/**
 * Fetches system data from ESP32
 * Called every 2 seconds by setInterval
 * 
 * @async
 * @returns {Promise<void>}
 */
async function fetchData() {
  try {
    const response = await fetch('/getData', {
      method: 'GET',
      headers: { 'Cache-Control': 'no-cache' }
    });
    
    if (!response.ok) {
      throw new Error(`HTTP ${response.status}`);
    }
    
    const data = await response.json();
    
    // Update UI elements
    updateElement('home-volt', data.voltage.toFixed(2) + ' V');
    updateElement('home-current', data.current.toFixed(3) + ' A');
    updateElement('home-joules', data.harvestedEnergy.toFixed(2) + ' J');
    
    // Update chart
    updateChart(data.voltage, data.harvestedEnergy);
    
    // Update slots
    if (data.slots && !activeSlotId) {
      for (let id = 1; id <= 3; id++) {
        const isOccupied = data.slots[id].occupied;
        setSlotState(id, isOccupied);
      }
    }
    
  } catch (error) {
    console.error('Data fetch error:', error);
  }
}
```

#### handleSlotClick()

```javascript
/**
 * Handles slot card click event
 * @param {number} id - Slot ID (1-3)
 * 
 * Workflow:
 * - If vacant: Request lock, show code
 * - If occupied: Show unlock modal
 */
async function handleSlotClick(id) {
  if (isSystemBusy) {
    showToast('System busy, please wait', 'warning');
    return;
  }
  
  activeSlotId = id;
  const slot = document.getElementById(`slot-${id}`);
  
  if (slot.classList.contains('occupied')) {
    // Show unlock modal
    document.getElementById('input-code').value = '';
    openModal('modal-unlock');
  } else {
    // Request lock
    isSystemBusy = true;
    
    try {
      const response = await fetch(`/requestLock?slot=${id}`);
      const data = await response.json();
      
      if (data.success) {
        // Update UI
        setSlotState(id, true, true);
        
        // Show code
        document.getElementById('disp-code').textContent = data.code;
        openModal('modal-code');
      } else {
        showToast('❌ ' + data.error, 'error');
        activeSlotId = null;
      }
    } catch (error) {
      showToast('❌ Connection failed', 'error');
      activeSlotId = null;
    } finally {
      isSystemBusy = false;
    }
  }
}
```

#### submitUnlock()

```javascript
/**
 * Submits unlock code to server
 * @async
 * 
 * Validates input and sends unlock request
 * Updates UI based on response
 */
async function submitUnlock() {
  const code = document.getElementById('input-code').value.trim();
  const errorEl = document.getElementById('errorCode');
  
  // Validate input
  if (!code || code.length !== 4) {
    errorEl.textContent = 'Enter 4-digit code';
    return;
  }
  
  if (!activeSlotId) {
    errorEl.textContent = 'Invalid session';
    return;
  }
  
  isSystemBusy = true;
  errorEl.textContent = '';
  
  try {
    const response = await fetch(
      `/unlockSlot?slot=${activeSlotId}&code=${code}`
    );
    const data = await response.json();
    
    if (data.success) {
      // Update slot UI
      setSlotState(activeSlotId, false, true);
      
      // Close modal
      closeModals();
      showToast('✅ Slot unlocked!', 'success');
      
      setTimeout(() => { 
        isSystemBusy = false; 
        activeSlotId = null; 
      }, 3000);
    } else {
      errorEl.textContent = data.error || 'Invalid code';
      isSystemBusy = false;
    }
  } catch (error) {
    errorEl.textContent = 'Network error';
    isSystemBusy = false;
  }
}
```

---

## 10. TESTING & VALIDATION

### 10.1 Unit Testing

#### Hardware Tests

**ESP32 Functionality**

- ✅ WiFi AP creation (SSID visible, connection successful)
- ✅ GPIO output (servo control pins functional)
- ✅ I2C communication (INA219 detected at 0x40)
- ✅ PWM generation (50Hz servo signal confirmed)
- ✅ SPIFFS mounting (web files accessible)

**Servo Operation**

- ✅ Angle accuracy (0° ±2°, 90° ±2° verified with protractor)
- ✅ Movement time (600ms measured with stopwatch)
- ✅ Detachment (current drops from 100mA to 0mA)
- ✅ Load capacity (holds 500g device securely)

**INA219 Sensor**

- ✅ Voltage reading (±0.5% error vs multimeter)
- ✅ Current reading (±1% error vs ammeter)
- ✅ I2C communication (no timeouts in 24hr test)
- ✅ Low-side configuration (voltage calculation verified)

**Battery & Charging**

- ✅ Voltage range (3.0V-4.2V confirmed)
- ✅ Charging circuit (TP4056 indicator LEDs functional)
- ✅ Protection (BMS cuts off at 2.9V, 4.25V)
- ✅ Capacity test (2800mAh measured vs 3000mAh rated)

### 10.2 Integration Testing

**WiFi & Web Server**

- ✅ AP stability (24hr continuous operation)
- ✅ Concurrent connections (4 devices tested)
- ✅ HTTP response time (<100ms average)
- ✅ Dashboard load time (<2s first load, <500ms refresh)
- ✅ File serving (HTML/CSS/JS delivered correctly)

**API Functionality**

- ✅ GET /getData (JSON format validated)
- ✅ GET /requestLock (code generation tested)
- ✅ GET /confirmLock (door closes correctly)
- ✅ GET /unlockSlot (code validation works)
- ✅ Error handling (400, 401, 409, 503 codes correct)

**Servo State Machine**

- ✅ Non-blocking operation (web responsive during movement)
- ✅ State transitions (IDLE→MOVING→COOLDOWN→IDLE)
- ✅ Busy prevention (concurrent requests rejected)
- ✅ Power saving (detachment confirmed)

### 10.3 System Testing

**Complete Lock/Unlock Cycle**

```
Test Case: User stores and retrieves device

Steps:
1. Connect to WiFi → ✅ Connected in 3 seconds
2. Open dashboard → ✅ Loaded in 1.8 seconds
3. Click vacant slot → ✅ Response immediate
4. Receive code "7284" → ✅ Code displayed
5. Place device → ✅ Physical placement OK
6. Click "Lock Door" → ✅ Door closes in 600ms
7. Verify slot shows "Charging" → ✅ UI updated
8. Click occupied slot → ✅ Unlock modal appears
9. Enter code "7284" → ✅ Input accepted
10. Click "Unlock" → ✅ Door opens in 600ms
11. Retrieve device → ✅ Physical retrieval OK
12. Verify slot shows "Available" → ✅ UI updated

Result: PASS (Total time: 45 seconds)
```

**Energy Monitoring Accuracy**

```
Test Procedure:
1. Connect lab power supply (3.7V, 0.1A = 0.37W)
2. Monitor for 1 hour
3. Compare measured vs expected energy

Expected:
  Energy = Power × Time
  Energy = 0.37W × 3600s = 1332 Joules

Measured:
  Dashboard: 1298 J
  Error: (1332-1298)/1332 = 2.5%

Result: PASS (within ±3% tolerance)
```

**Concurrent User Test**

```
Test: 3 users accessing system simultaneously

User A: Locks slot 1 → ✅ Success, code: 3891
User B: Locks slot 2 → ✅ Success, code: 6452
User C: Locks slot 3 → ✅ Success, code: 2107
User A: Unlocks slot 1 → ✅ Success
User B: Unlocks slot 2 → ✅ Success  
User C: Unlocks slot 3 → ✅ Success

Result: PASS (no race conditions observed)
```

### 10.4 Stress Testing

**24-Hour Continuous Operation**

- ✅ Uptime: 24 hours, 0 crashes
- ✅ WiFi stability: 0 disconnections
- ✅ Memory leaks: RAM usage stable (68%)
- ✅ Lock/unlock cycles: 157 successful operations
- ✅ Temperature: ESP32 @ 48°C (within spec)

**Rapid Lock/Unlock**

```
Test: 50 consecutive lock/unlock operations

Slot 1: 50/50 successful (100%)
Slot 2: 50/50 successful (100%)
Slot 3: 50/50 successful (100%)
Average time per cycle: 2.3 seconds
No servo failures observed

Result: PASS
```

**Invalid Code Attempts**

```
Test: Wrong code entry handling

Trial 1: Wrong code → ✅ Rejected, error shown
Trial 2: Empty code → ✅ Validation error
Trial 3: 3-digit code → ✅ Format error
Trial 4: Correct code → ✅ Unlocked successfully

Result: PASS (security validation working)
```

### 10.5 Performance Metrics

|Metric|Target|Achieved|Status|
|---|---|---|---|
|Servo Response|<1s|600ms|✅ PASS|
|API Latency|<200ms|85ms avg|✅ PASS|
|Dashboard Update|2s|2s|✅ PASS|
|WiFi Uptime|>23h/day|24h|✅ PASS|
|Code Generation|<50ms|8ms|✅ PASS|
|Energy Accuracy|±5%|±2.5%|✅ PASS|
|Concurrent Users|≥3|4 tested|✅ PASS|
|Battery Runtime|>8h|11.7h|✅ PASS|

---

## 11. CHALLENGES & SOLUTIONS

### 11.1 Technical Challenges

#### Challenge 1: Servo Blocking

**Problem**: Using `delay()` for servo movement caused entire system freeze. Web server became unresponsive for 600ms during each operation.

**Impact**:

- Dashboard appeared laggy
- Concurrent requests failed
- Poor user experience

**Solution**: Implemented non-blocking state machine:

```cpp
// Instead of:
servo.write(90);
delay(600);  // ❌ Blocks everything
servo.detach();

// Use state machine:
enum ServoState { IDLE, MOVING, COOLDOWN };
// Check elapsed time in loop()
if (currentTask.state == MOVING && 
    millis() - startTime >= 600) {
  currentTask.state = COOLDOWN;
}
```

**Result**:

- System remains responsive during servo operations
- Web requests processed within 100ms even during movement
- Smooth user experience

---

#### Challenge 2: INA219 Low-Side Sensing

**Problem**: In low-side configuration (shunt between load and ground), INA219's bus voltage reads ~0V instead of battery voltage.

**Impact**:

- Incorrect battery voltage reading (showed 0.05V instead of 3.7V)
- Energy calculation completely wrong
- Battery percentage always showed 0%

**Solution**: Calculate battery voltage from power and current:

```cpp
if (busVoltage < 0.1) {
  // Low-side config detected
  batteryVoltage = power / current;  // V = P/I
} else {
  // High-side config
  batteryVoltage = busVoltage + shuntVoltage;
}
```

**Result**:

- Accurate battery voltage (±0.5% error)
- Correct energy accumulation
- Reliable battery percentage display

---

#### Challenge 3: Race Conditions in Slot Management

**Problem**: Multiple users clicking same slot simultaneously could create conflicting states.

**Impact**:

- Two users might get same slot
- Slot data corruption
- Lost unlock codes

**Solution**: Implemented busy flag and HTTP status codes:

```cpp
// Check if servo busy
if (currentTask.state != IDLE) {
  server.send(503, "application/json", 
    "{\"error\":\"System busy\"}");
  return;
}

// JavaScript side
if (isSystemBusy) {
  showToast('Please wait...', 'warning');
  return;
}
```

**Result**:

- Prevented concurrent operations
- Clear user feedback when system busy
- No slot conflicts in testing

---

#### Challenge 4: Energy Calculation Accuracy

**Problem**: Initial implementation used instantaneous power (P = V×I) instead of integrating over time, leading to huge energy values.

**Impact**:

- Energy reading showed 50,000J after 1 minute (impossible)
- Unrealistic harvesting claims
- Incorrect analytics

**Solution**: Proper energy integration:

```cpp
// Wrong approach:
energy = voltage * current;  // ❌ This is power, not energy

// Correct approach:
float Δt = (currentTime - lastTime) / 1000.0;  // seconds
float charge = current * Δt;  // Coulombs (A·s)
float energy = charge * voltage;  // Joules (C·V)
totalEnergy += energy;  // Accumulate
```

**Result**:

- Realistic energy values (~1-5J per minute with low current)
- Accurate Wh conversion (1J = 0.000278Wh)
- Verifiable with external measurements

---

#### Challenge 5: SPIFFS Upload Failure

**Problem**: Web files (HTML/CSS/JS/images) exceeded 1MB, couldn't upload to SPIFFS.

**Impact**:

- Dashboard wouldn't load
- 404 errors for all resources
- System unusable

**Solution**:

- Minified CSS and JavaScript
- Compressed images (JPEG quality 80%)
- Used Chart.js CDN link instead of local file
- Partitioned SPIFFS to 2MB

**Result**:

- Total file size: ~850KB
- All files fit in SPIFFS
- Dashboard loads successfully

---

#### Challenge 6: Servo Power Consumption

**Problem**: Three servos holding position consumed 300mA combined, draining battery quickly.

**Impact**:

- Battery lasted only 4 hours
- Excessive heat generation
- Reduced harvesting efficiency

**Solution**: Detach servos after movement:

```cpp
// Move servo
servo.write(targetAngle);
delay(SERVO_MOVE_DELAY);  // Wait to reach position

// Detach to save power
servo.detach();  // ✅ Drops current from 100mA to 0mA
```

**Result**:

- Power consumption reduced by 75%
- Battery runtime increased to 11.7 hours
- Cooler operation

---

### 11.2 Design Challenges

#### Challenge 7: User Experience Design

**Problem**: Initial design had complex multi-step process confusing users.

**Solution**:

- Simplified to 2-step process: Click → Code → Lock
- Added visual feedback (color changes, animations)
- Implemented toast notifications
- Clear error messages

---

#### Challenge 8: Security Balance

**Problem**: Need security without over-complication for users.

**Solution**:

- 4-digit codes (simple but 10,000 combinations)
- Admin override for emergencies
- Session-based codes (cleared after use)
- No permanent passwords to remember

---

#### Challenge 9: Piezoelectric Voltage Threshold Under Real Foot Traffic

**Problem**: During stair deployment, normal foot traffic generated piezoelectric output voltage below the minimum operating threshold of the 1000µF smoothing capacitor. The capacitor could not accumulate sufficient charge to trigger the TP4056 charging cycle under typical use conditions.

**Impact**:

- Piezoelectric energy could not reliably flow into the battery during deployment
- The 18650 battery served as the primary energy buffer rather than receiving incremental piezo charging
- Dashboard energy readings reflect battery charge state as a proxy, not direct piezo output measurement
- The 8J/day harvesting figure (Section 12.2) represents theoretical potential under ideal conditions, not measured deployment output

**Root Cause Analysis**:

The prototype stair installation used four 35mm PZT disc elements. While lab testing confirmed correct AC output (10–30V peak), the force profile of normal foot traffic distributed across a stair surface produced lower-amplitude, shorter-duration pulses than the bench tests. The 1000µF capacitor requires sustained charging cycles to reach the TP4056 input threshold; intermittent low-force pulses dissipated before the threshold was reached.

**Deployed Workaround**:

The system was powered directly from the pre-charged 18650 battery. The piezoelectric circuit remains wired and functional as a demonstrative component. The INA219 monitors battery voltage and current, providing real-time energy state that is displayed on the dashboard.

**Circuit Design Status**:

The energy conversion chain (Piezo → Rectifier → Capacitor → TP4056 → Battery) is theoretically correct and validated in controlled lab conditions. This is a deployment scaling constraint, not a design flaw.

**Proposed Hardware Fix for Future Iteration**:

```
Option A — Lower-threshold capacitor:
  Replace 1000µF/50V with 100µF/50V
  Reduces charge accumulation time per pulse
  Trade-off: Less smoothing, more ripple to TP4056

Option B — Dedicated energy harvesting IC:
  LTC3588-1 or similar piezo energy harvester IC
  Designed specifically for low-voltage, intermittent piezo input
  Built-in rectifier and ultra-low threshold start-up

Option C — Joule thief / boost converter pre-stage:
  Step up low-voltage piezo pulses before capacitor
  Allows smaller, lower-voltage pulses to contribute to charging

Option D — Direct measurement sensor:
  Add second INA219 between rectifier output and capacitor
  Captures actual harvested energy before battery buffer
  Enables true harvesting measurement independent of load
```

**Result**: The core system — secure charging slots, web dashboard, access control, and energy monitoring — operates fully as intended. The deployment limitation is isolated to the piezoelectric-to-capacitor charging stage and does not affect any other system function.

---

## 12. RESULTS & PERFORMANCE

### 12.1 System Performance

**Operational Metrics** (Measured over 7-day test period)

|Parameter|Result|
|---|---|
|**System Uptime**|99.8% (168 hours, 1 restart)|
|**Average Response Time**|87ms (API requests)|
|**Lock/Unlock Success Rate**|100% (423/423 operations)|
|**Code Validation Accuracy**|100% (0 false positives/negatives)|
|**WiFi Connection Stability**|100% (0 disconnections)|
|**Energy Measurement Error**|±2.1% (vs lab instruments)|
|**Dashboard Load Time**|1.9s (average first load)|
|**Page Refresh Time**|0.4s (average)|

### 12.2 Energy Harvesting Results

**Piezoelectric Output** (4 elements, manual testing)

|Test Condition|Voltage (V)|Current (µA)|Power (µW)|Energy per Press (mJ)|
|---|---|---|---|---|
|Light tap (10N)|8-12V|50-100|400-1200|2-3|
|Normal step (30N)|15-22V|150-300|2250-6600|8-12|
|Heavy step (50N)|25-30V|300-500|7500-15000|15-20|

**Daily Harvesting Simulation** (Theoretical — 8 hours, moderate traffic)

> **Important**: The following is a theoretical calculation based on lab-measured piezo element output and assumed foot traffic. During actual stair deployment, the capacitor voltage threshold was not consistently met, so this figure represents the system's potential under ideal conditions, not measured deployment output.

```
Assumptions:
- 4 piezo elements
- 100 steps per hour
- Average 10mJ per step

Calculation:
  Energy per hour = 100 steps × 10mJ = 1000mJ = 1J
  Energy per 8 hours = 8J
  Energy in Wh = 8J ÷ 3600 = 0.0022Wh

Battery Capacity: 3000mAh × 3.7V = 11.1Wh
Harvested Energy: 0.0022Wh
Percentage: 0.0022 ÷ 11.1 × 100 = 0.02% per day
```

**Note**: Results show piezoelectric harvesting alone cannot fully power the system, but provides supplemental charging. System designed to demonstrate concept and technology integration.

### 12.3 Power Consumption Analysis

**Component Power Draw** (Measured with INA219)

|Mode|Components Active|Current (mA)|Power (mW)|
|---|---|---|---|
|Idle|ESP32 + INA219|165|825|
|WiFi TX|ESP32 transmitting|240|1200|
|Servo Moving|ESP32 + 1 Servo|580|2900|
|Peak|ESP32 + 3 Servos|1450|7250|

**Daily Power Budget**

```
Idle: 165mA × 23.9 hours = 3943.5 mAh
WiFi: (240-165)mA × 0.1 hours = 7.5 mAh
Servo: 20 operations × 2s × (580-165)mA = 2.3 mAh

Total: 3953.3 mAh per day
Battery: 3000 mAh
Runtime: 3000 ÷ (3953.3/24) = 18.2 hours

With harvesting (+8J/day = 2.16mAh):
Runtime: 3000 ÷ ((3953.3-2.16)/24) = 18.2 hours
```

### 12.4 User Testing Results

**Participants**: 15 users (5 engineering students, 10 general public)

**Task Success Rate**:

- Connect to WiFi: 100% (15/15)
- Open dashboard: 100% (15/15)
- Lock device: 93% (14/15, 1 forgot to click confirm)
- Unlock device: 100% (14/14)
- Overall satisfaction: 4.6/5.0

**Feedback Summary**:

- **Positive**: Simple interface, fast response, clear instructions
- **Negative**: Would like mobile app, LED indicators on physical unit
- **Suggestions**: RFID cards, email/SMS notifications

### 12.5 Comparison with Project Objectives

|Objective|Target|Achieved|Status|
|---|---|---|---|
|Harvest renewable energy|Functional|✅ Circuit functional; 8J/day theoretical (lab)|ACHIEVED (with deployment note)|
|Store in battery|3.0-4.2V|✅ 3.7V avg|ACHIEVED|
|Secure device storage|3 slots|✅ 3 slots|ACHIEVED|
|Access control|Code-based|✅ 4-digit codes|ACHIEVED|
|Battery state monitoring|<5s update|✅ 2s update|EXCEEDED|
|Web interface|Responsive|✅ Mobile-friendly|ACHIEVED|
|Energy accuracy|±5%|✅ ±2.1%|EXCEEDED|
|Uptime|>95%|✅ 99.8%|EXCEEDED|

---

## 13. FUTURE ENHANCEMENTS

### 13.1 Short-Term Improvements (3-6 months)

**1. Physical Enhancements**

- LED status indicators on each slot (red=occupied, green=available)
- Buzzer for audio feedback (beep on lock/unlock)
- LCD display showing battery level and status
- Improved enclosure with professional finish

**2. Software Features**

- Mobile app (Android/iOS) with push notifications
- User accounts and lock history
- Scheduled access (time-based unlock)
- Remote monitoring via cloud platform

**3. Security Upgrades**

- RFID/NFC card support
- Biometric unlock (fingerprint scanner)
- Email/SMS code delivery
- Failed attempt logging and alerts

### 13.2 Medium-Term Enhancements (6-12 months)

**1. Energy System**

- Solar panel integration (5W panel)
- Multiple battery cells in parallel (18650 × 3)
- MPPT charge controller
- Wireless charging pads in slots

**2. Connectivity**

- MQTT protocol for IoT integration
- Cloud logging (ThingSpeak, AWS IoT)
- Webhook support for automation
- Bluetooth LE for local control

**3. Analytics**

- Machine learning for usage patterns
- Energy prediction algorithms
- Maintenance alerts (low battery warnings)
- Usage statistics dashboard

### 13.3 Long-Term Vision (1-2 years)

**1. Commercial Product**

- Mass production with injection-molded case
- Certified components (UL, CE, FCC)
- User manual and quickstart guide
- Warranty and support system

**2. Scalability**

- Expandable to 6, 9, or 12 slots
- Modular design (stack multiple units)
- Network mode (multiple stations, one controller)
- Central management dashboard

**3. Advanced Features**

- AI-powered slot assignment optimization
- Dynamic pricing (longer storage = higher energy cost)
- Integration with building management systems
- Payment gateway (coin/card operated)

### 13.4 Research Opportunities

**1. Energy Optimization**

- Study different piezo element configurations
- Test alternative energy harvesting methods
- Optimize charging algorithms
- Develop predictive energy models

**2. User Experience**

- Conduct large-scale user studies
- A/B testing of interface designs
- Accessibility improvements (screen readers, large text)
- Multi-language support

**3. Technical Innovation**

- Ultra-low power ESP32 sleep modes
- Energy harvesting from electromagnetic fields
- Self-healing mechanical mechanisms
- Biodegradable enclosure materials

---

## 14. CONCLUSION

### 14.1 Project Summary

PiezoStation successfully demonstrates the integration of:

- **Renewable Energy**: Piezoelectric harvesting converts mechanical energy to electrical
- **Embedded Systems**: ESP32 controls all hardware and software components
- **IoT Technology**: Web-based interface enables remote monitoring and control
- **Security**: Code-based access control protects user devices
- **Real-Time Monitoring**: Battery state and energy tracking via INA219, updated every 2 seconds

### 14.2 Key Achievements

✅ **Functional Prototype**: Fully operational 3-slot charging station  
✅ **Energy Harvesting**: Piezoelectric circuit functional and validated in lab; deployment limited by capacitor voltage threshold under normal foot traffic (see Section 11, Challenge 9)  
✅ **Secure Access**: 100% success rate in lock/unlock operations  
✅ **User-Friendly**: 4.6/5.0 average satisfaction rating  
✅ **Reliable**: 99.8% uptime over 7-day test period  
✅ **Accurate**: ±2.1% energy measurement error  
✅ **Responsive**: 87ms average API response time  
✅ **Professional**: Complete web dashboard with analytics

### 14.3 Learning Outcomes

**Technical Skills Developed**:

- ESP32 firmware development in C++
- Web technologies (HTML/CSS/JavaScript)
- RESTful API design and implementation
- Circuit design and hardware integration
- Energy systems and power management
- Real-time data visualization

**Soft Skills Gained**:

- Project management and teamwork
- Technical documentation writing
- Problem-solving under constraints
- User experience design
- Presentation and communication

### 14.4 Real-World Applications

This project demonstrates practical applications in:

- **Public Spaces**: Airports, malls, universities
- **Events**: Concerts, conferences, festivals
- **Transportation**: Train stations, bus terminals
- **Workplaces**: Offices, co-working spaces
- **Healthcare**: Hospitals, clinics (secure device storage)

### 14.5 Impact & Significance

**Educational Impact**:

- Demonstrates practical engineering concepts
- Bridges theory and real-world application
- Inspires future renewable energy projects

**Environmental Impact**:

- Promotes renewable energy awareness
- Reduces reliance on grid power
- Demonstrates sustainable technology

**Social Impact**:

- Provides convenient device charging solution
- Enhances security for personal electronics
- Accessible technology for diverse users

### 14.6 Acknowledgments

**St. John Paul II College of Davao**

- College of Engineering for facilities and support
- Faculty advisors for guidance and mentorship
- IECEP SJP2CD Chapter for professional development

**Team Members**

- Ike Hingo: Comprehensive research and documentation
- Johncel Anthony Lada: Full-stack system development
- Riche Kye Pobadora: Precision hardware assembly

**Open Source Community**

- ESP32 Arduino Core developers
- Adafruit for INA219 library
- Chart.js contributors

### 14.7 Final Remarks

PiezoStation represents a successful integration of computer engineering principles, renewable energy technology, and user-centered design. The energy harvesting circuit is theoretically sound and validated under controlled lab conditions. During prototype stair deployment, piezoelectric output fell below the smoothing capacitor's operating threshold under normal foot traffic — a scaling constraint that is well-understood, documented, and addressable in a future iteration with a dedicated energy harvesting IC or lower-threshold capacitor stage.

The system's high reliability (99.8% uptime), user satisfaction (4.6/5.0), and measurement accuracy (±2.1% error) validate the technical implementation. The non-blocking architecture, secure access control, and professional web interface showcase modern embedded systems and IoT development best practices.

This capstone project serves as a foundation for future work in renewable energy systems, smart IoT devices, and sustainable technology solutions. The lessons learned — including the real-world gap between theoretical circuit design and deployment conditions — provide valuable engineering insight for the next generation of computer engineering students.

---

## APPENDICES

### Appendix A: Bill of Materials (BOM)

| Item | Quantity | Unit Price | Total | Supplier |
| --- | --- | --- | --- | --- |
| ESP32 Development Board | 1 | ₱350 | ₱350 | Local electronics  |
| SG90 Servo Motor | 3 | ₱120 | ₱360 | Online |
| INA219 Module | 1 | ₱180 | ₱180 | Online |
| 18650 Battery | 1 | ₱200 | ₱200 | Local battery shop |
| TP4056 Charger | 1 | ₱35 | ₱35 | Online |
| Piezo Discs (35mm) | 4 | ₱80 | ₱320 | Online |
| 1N4007 Diodes | 4 | ₱5 | ₱20 | Local electronics  |
| Capacitors (1000µF) | 2 | ₱15 | ₱30 | Local electronics  |
| Buck Converter | 1 | ₱60 | ₱60 | Online |
| Jumper Wires | 1 set | ₱80 | ₱80 | Local electronics  |
| Breadboard | 1 | ₱150 | ₱150 | Local electronics  |
| Enclosure Materials | 1 | ₱300 | ₱300 | Hardware store |
| Miscellaneous | - | ₱200 | ₱200 | Various |
| **TOTAL** | | | **₱2,285** | |

### Appendix B: Pin Assignment Table

| Pin | Function | Component | Notes |
| --- | --- | --- | --- |
| GPIO 14 | PWM Output | Servo 1 Signal | 50Hz, 1-2ms pulse |
| GPIO 27 | PWM Output | Servo 2 Signal | 50Hz, 1-2ms pulse |
| GPIO 26 | PWM Output | Servo 3 Signal | 50Hz, 1-2ms pulse |
| GPIO 21 | I2C SDA | INA219 Data | 4.7kΩ pullup |
| GPIO 22 | I2C SCL | INA219 Clock | 4.7kΩ pullup |
| 5V | Power | Servos VCC | From buck converter |
| 3.3V | Power | INA219 VCC | ESP32 regulated |
| GND | Common Ground | All components | Single ground bus |

### Appendix C: API Documentation

Complete API reference available in separate document: `API_Documentation.md`

### Appendix D: Circuit Diagrams

Detailed schematics available in separate document: `Circuit_Schematics.pdf`

### Appendix E: Source Code Repository

GitHub Repository: `github.com/piezostation/firmware` (example)

---

**Document Version**: 1.1  
**Last Updated**: March 9, 2026  
**Authors**: Ike Hingo, Johncel Anthony Lada, Riche Kye Pobadora  
**Institution**: St. John Paul II College of Davao  
**Program**: BS Computer Engineering  
**Academic Year**: 2025-2026

---

_© 2026 PiezoStation Development Team. All rights reserved._
