janolada/Piezoelectric-Charging-Station/piezo_station/docs/Dashboard Snippet/dashboard002.png

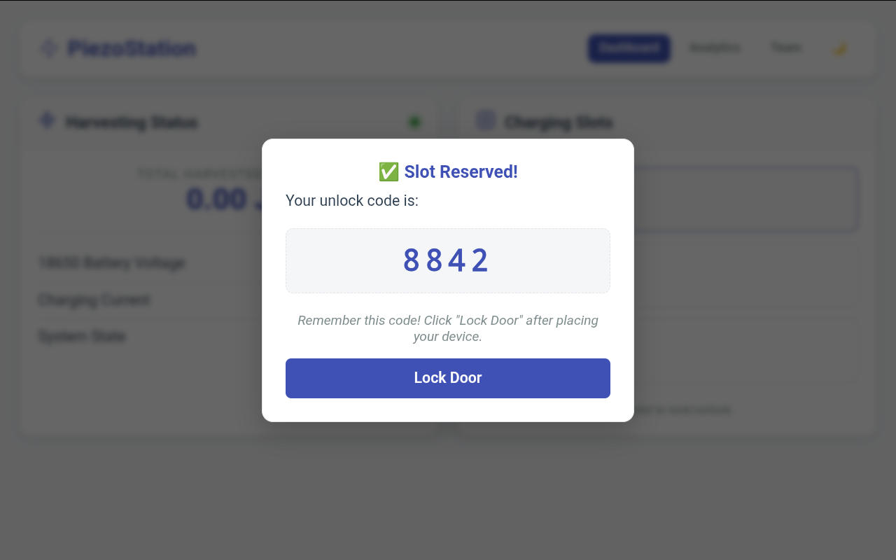
piezo_station/docs/Dashboard Snippet/dashboard002.png
