janolada/Piezoelectric-Charging-Station/piezo_station/docs/Dashboard Snippet/dashboard003.png

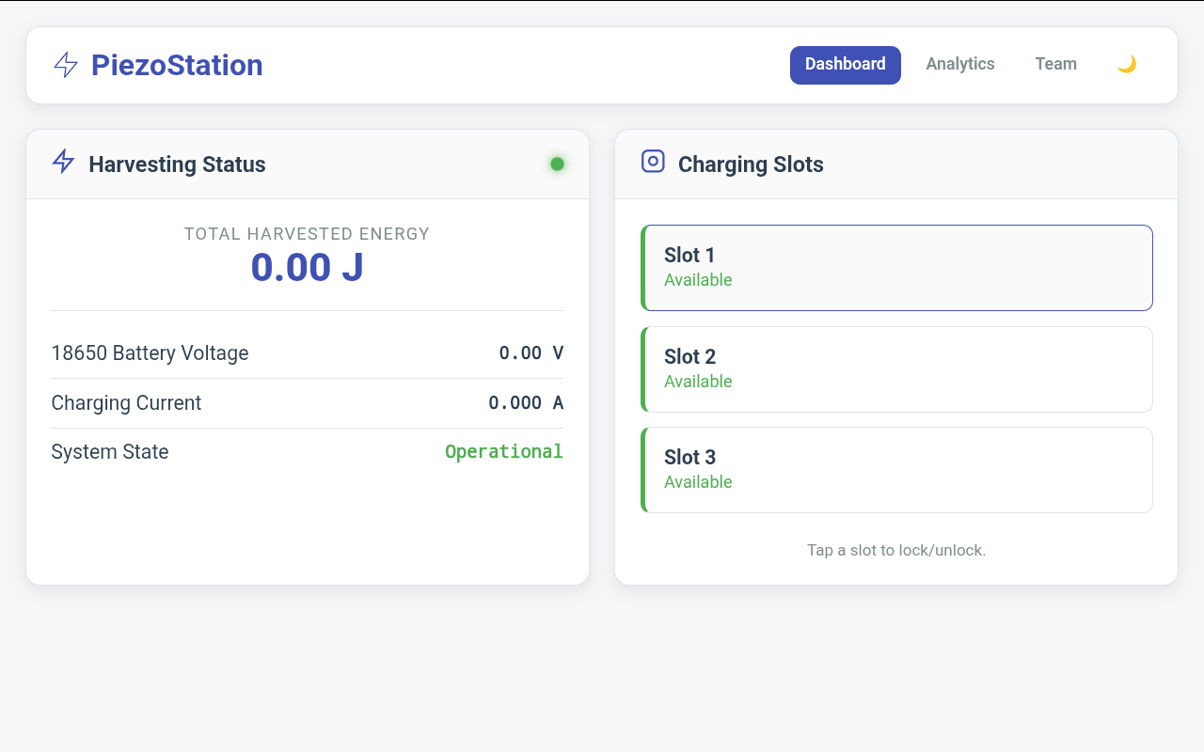
piezo_station/docs/Dashboard Snippet/dashboard003.png
