janolada/Piezoelectric-Charging-Station/piezo_station/docs/Dashboard Snippet/dashboard004.png

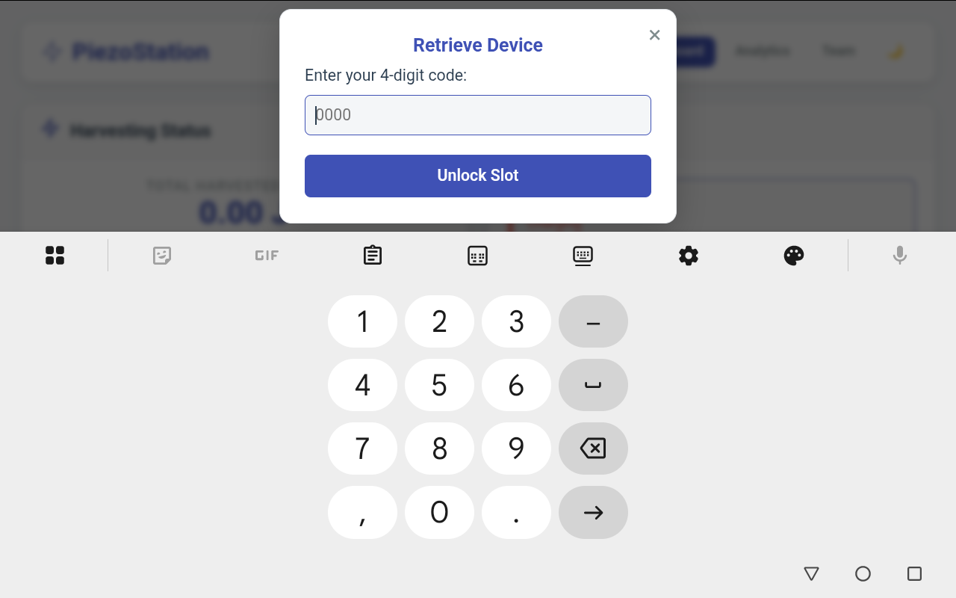
piezo_station/docs/Dashboard Snippet/dashboard004.png
