janolada/Piezoelectric-Charging-Station/piezo_station/firmware/data/assets/coe.jpg

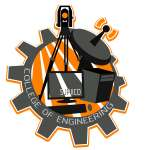
piezo_station/firmware/data/assets/coe.jpg
