janolada/Piezoelectric-Charging-Station/piezo_station/firmware/data/assets/johncel.jpeg

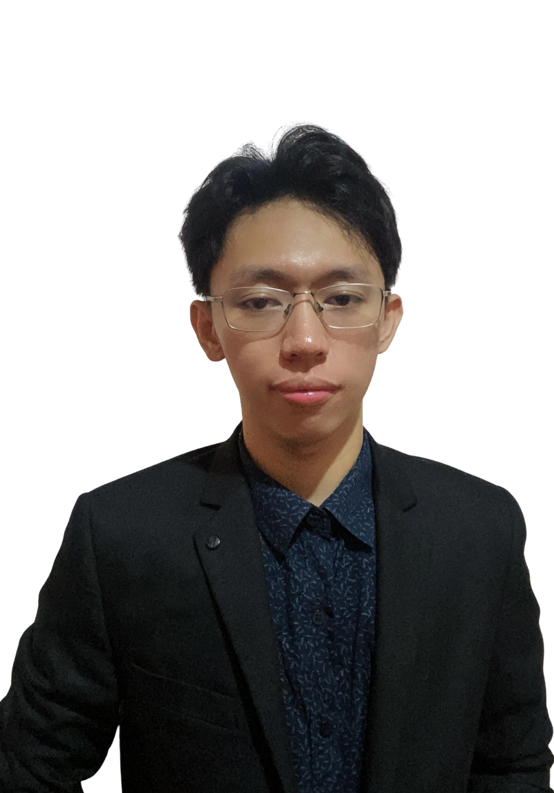
piezo_station/firmware/data/assets/johncel.jpeg
