janolada/Piezoelectric-Charging-Station/piezo_station/firmware/data/assets/riche.jpg

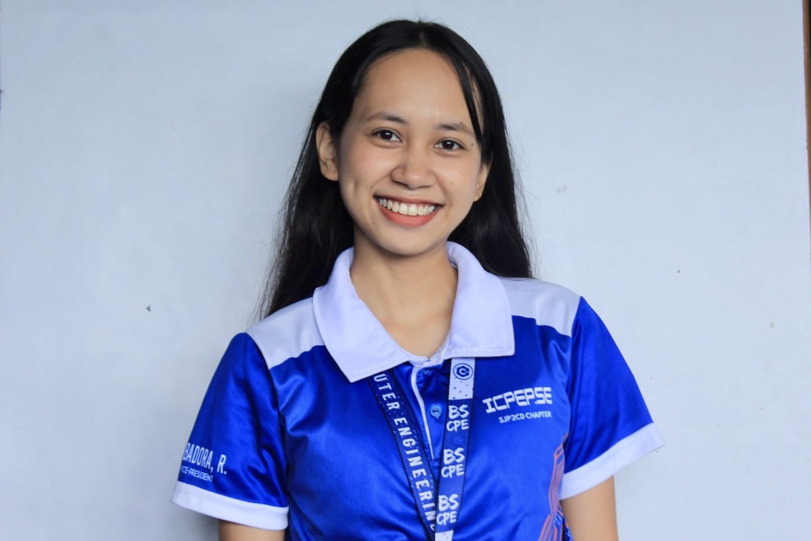
piezo_station/firmware/data/assets/riche.jpg
