janolada/Piezoelectric-Charging-Station/piezo_station/firmware/data/assets/sjp2cd.jpg

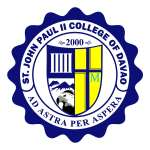
piezo_station/firmware/data/assets/sjp2cd.jpg
